tekkies/esp-12e-alexa-door-bell/hardware/esp-12e-alexa-door-bell.VeeCAD.front.pdf

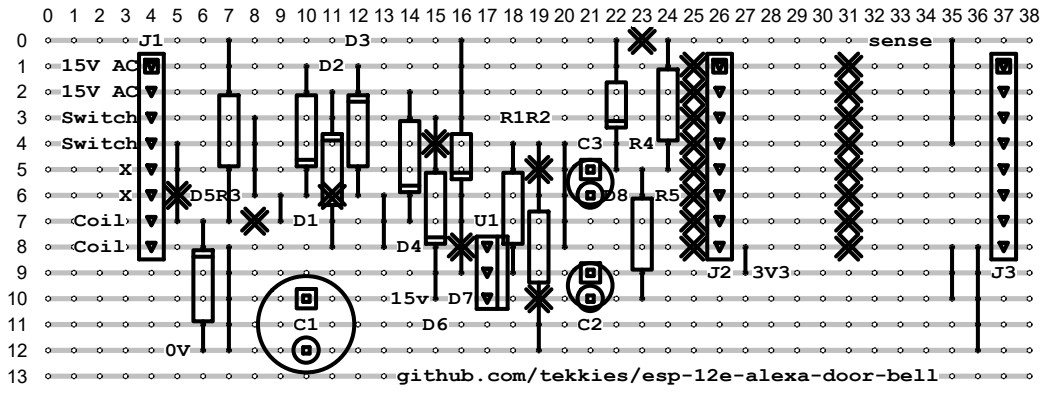
[picture p5: page 1]

github.com/tekkies/esp-12e-alexa-door-bell
