tekkies/esp-12e-alexa-door-bell/hardware/esp-12e-alexa-door-bell.VeeCAD.rear.pdf

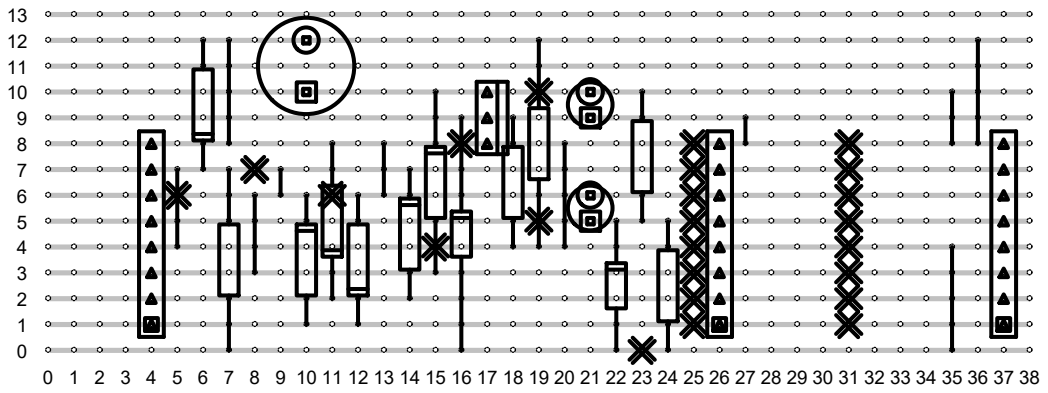
[picture p6: page 1]
