tekkies/esp-12e-alexa-door-bell/hardware/power-supply.ltspice.asc

15VAC.1: jumper
15VAC.2: jumper
C1: cap; 330µ
C2: cap; 10µ
C3: cap; 4.7µ
D1: diode
D2: diode
D3: diode
D4: diode
D5: diode
D6: diode
D7: diode
D8: diode
L1: ind; 10µH; Rser=5
R1: res; 200
R2: res; 330R
R3: res; 1k
R4: res; 10K
R5: res; 10k
Rload: res; 16.5
S1: sw; MYSW
SOL.1: jumper
SOL.2: jumper
SW.1: jumper
SW.2: jumper
U1: LM317
V1: voltage; SINE(0 14.5 50)
V2: voltage; PULSE(0 12 0.01 0.00000001 0.00000001 0.08 0.17 2)
X1: jumper
X2: jumper
X3: jumper
Named nets: 0, Vc, Sense, Vswitch, 0V, 3.4V, Vac, switch_pressed
.tran 0.5
.model MYSW SW(Ron=1 Roff=1Meg Vt=.5 Vh=-.4)
