tekkies/esp-12e-alexa-door-bell/(list of files, drawings)

Other design files:
hardware/esp-12e-alexa-door-bell.TinyCad.dsn
