tekkies/esp-12e-alexa-door-bell/src/esp-12e-alexa-door-bell/States.hpp

#pragma once
#include "Interfaces.hpp"
#include "StateIds.hpp"
#include "Hsm/StateMachineBase.hpp"
#include "Hsm/Function.hpp"

namespace
{
class StateBase : public hsm::StateBase, public IEvents
{
public:
    StateBase(IActions* _actions, IGuards* _guards)
        : actions(_actions)
        , guards(_guards)
    {}

    virtual ~StateBase(){}

protected:
    IActions* actions;
    IGuards* guards;
};

class FloHsmInitial_5OdpEA31BEcPrWrNx8u7 : public StateBase
{
public:
    FloHsmInitial_5OdpEA31BEcPrWrNx8u7(StateId fromState, StateId toState, IActions* _actions, IGuards* _guards)
        : StateBase(_actions, _guards)
    {
        if (MustCallEntry(Id, fromState, toState))
        {
            SetTransitionDetails(StateId_ConnectWiFi, Function());
        }
    }

    virtual ~FloHsmInitial_5OdpEA31BEcPrWrNx8u7()
    {}

    StateId GetId() const override { return Id; }
    
private:
    static const StateId Id = StateId_FloHsmInitial_5OdpEA31BEcPrWrNx8u7;

};

class ConnectWiFi : public StateBase
{
public:
    ConnectWiFi(StateId, StateId, IActions* _actions, IGuards* _guards)
        : StateBase(_actions, _guards)
    {}

    virtual ~ConnectWiFi()
    {}

    void WiFi_is_connected() override
    {
        SetTransitionDetails(StateId_Sense, Function(&IActions::Print_connected, actions));
    }

    StateId GetId() const override { return Id; }
    
private:
    static const StateId Id = StateId_ConnectWiFi;

};

class Sense : public StateBase
{
public:
    Sense(StateId, StateId, IActions* _actions, IGuards* _guards)
        : StateBase(_actions, _guards)
    {}

    virtual ~Sense()
    {}

    void SwitchIsPushed() override
    {
        SetTransitionDetails(StateId_Report, Function(&IActions::PrintSwitchIsPushed, actions));
    }

    StateId GetId() const override { return Id; }
    
private:
    static const StateId Id = StateId_Sense;

};

class Report : public StateBase
{
public:
    Report(StateId fromState, StateId toState, IActions* _actions, IGuards* _guards)
        : StateBase(_actions, _guards)
    {
        if (MustCallEntry(Id, fromState, toState))
        {
            actions->NotifyAlexa();
        }
    }

    virtual ~Report()
    {}

    void ReportSuccessful() override
    {
        SetTransitionDetails(StateId_Sense, Function());
    }

    StateId GetId() const override { return Id; }
    
private:
    static const StateId Id = StateId_Report;

};

}
