tekkies/esp-12e-alexa-door-bell/(commit log)

2023-02-27 Call test webhook when button press sensed
    https://webhook.site/#!/7a5ecee2-0d25-49d8-8f81-1bee70adbafc
    [esp-12e-alexa-door-bell.TinyCad.dsn]
2023-03-03 Print "WiFi Connected"
2023-03-03 Print "Switch was pushed"
2023-03-05 Print URL, adjust startup sequence
2023-03-05 Turn on LED while busy with https
2023-03-05 Characterize the voltage controlled switch
2023-03-05 Simulated switch and low backEMF
2023-03-05 Connect the switch after the rectifier
2023-03-05 Close, but power supply is dipping
2023-03-05 DC Solenoid
2023-03-05 Don't drive the pin too hard
2023-03-05 TinyCad Regulator copied
    [esp-12e-alexa-door-bell.TinyCad.dsn]
2023-03-05 TinyCAD no errors
    [esp-12e-alexa-door-bell.TinyCad.dsn]
2023-03-05 Cleaner circuit
    [esp-12e-alexa-door-bell.TinyCad.dsn]
2023-03-05 TinyCAD layout done
    [esp-12e-alexa-door-bell.TinyCad.dsn]
2023-03-08 Layout regulator
2023-03-10 LED Flashes indicate state
